DonSlaughter/garage-door/pcb/ext_libs/TSR_2-2450/TSR_2-2450.step

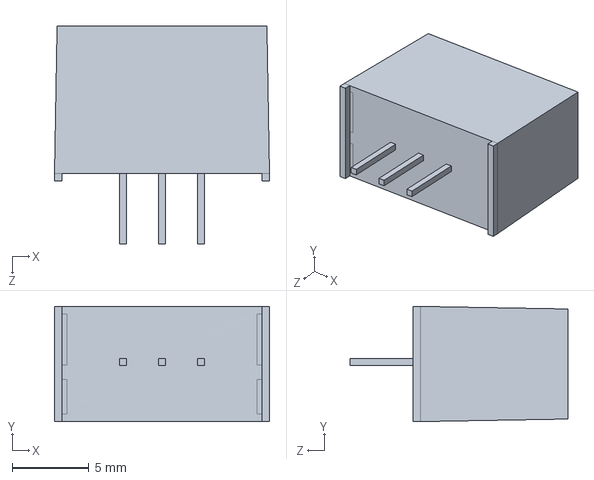
[picture p1: CAD file, 2022-01-19]
pcb/ext_libs/TSR_2-2450/TSR_2-2450.step
14.0 x 7.50 x 14.2 mm
