DonSlaughter/garage-door/pcb/garagen_pcb.kicad_pcb

## KiCad design pcb/garagen_pcb.kicad_pcb (2022-01-19)

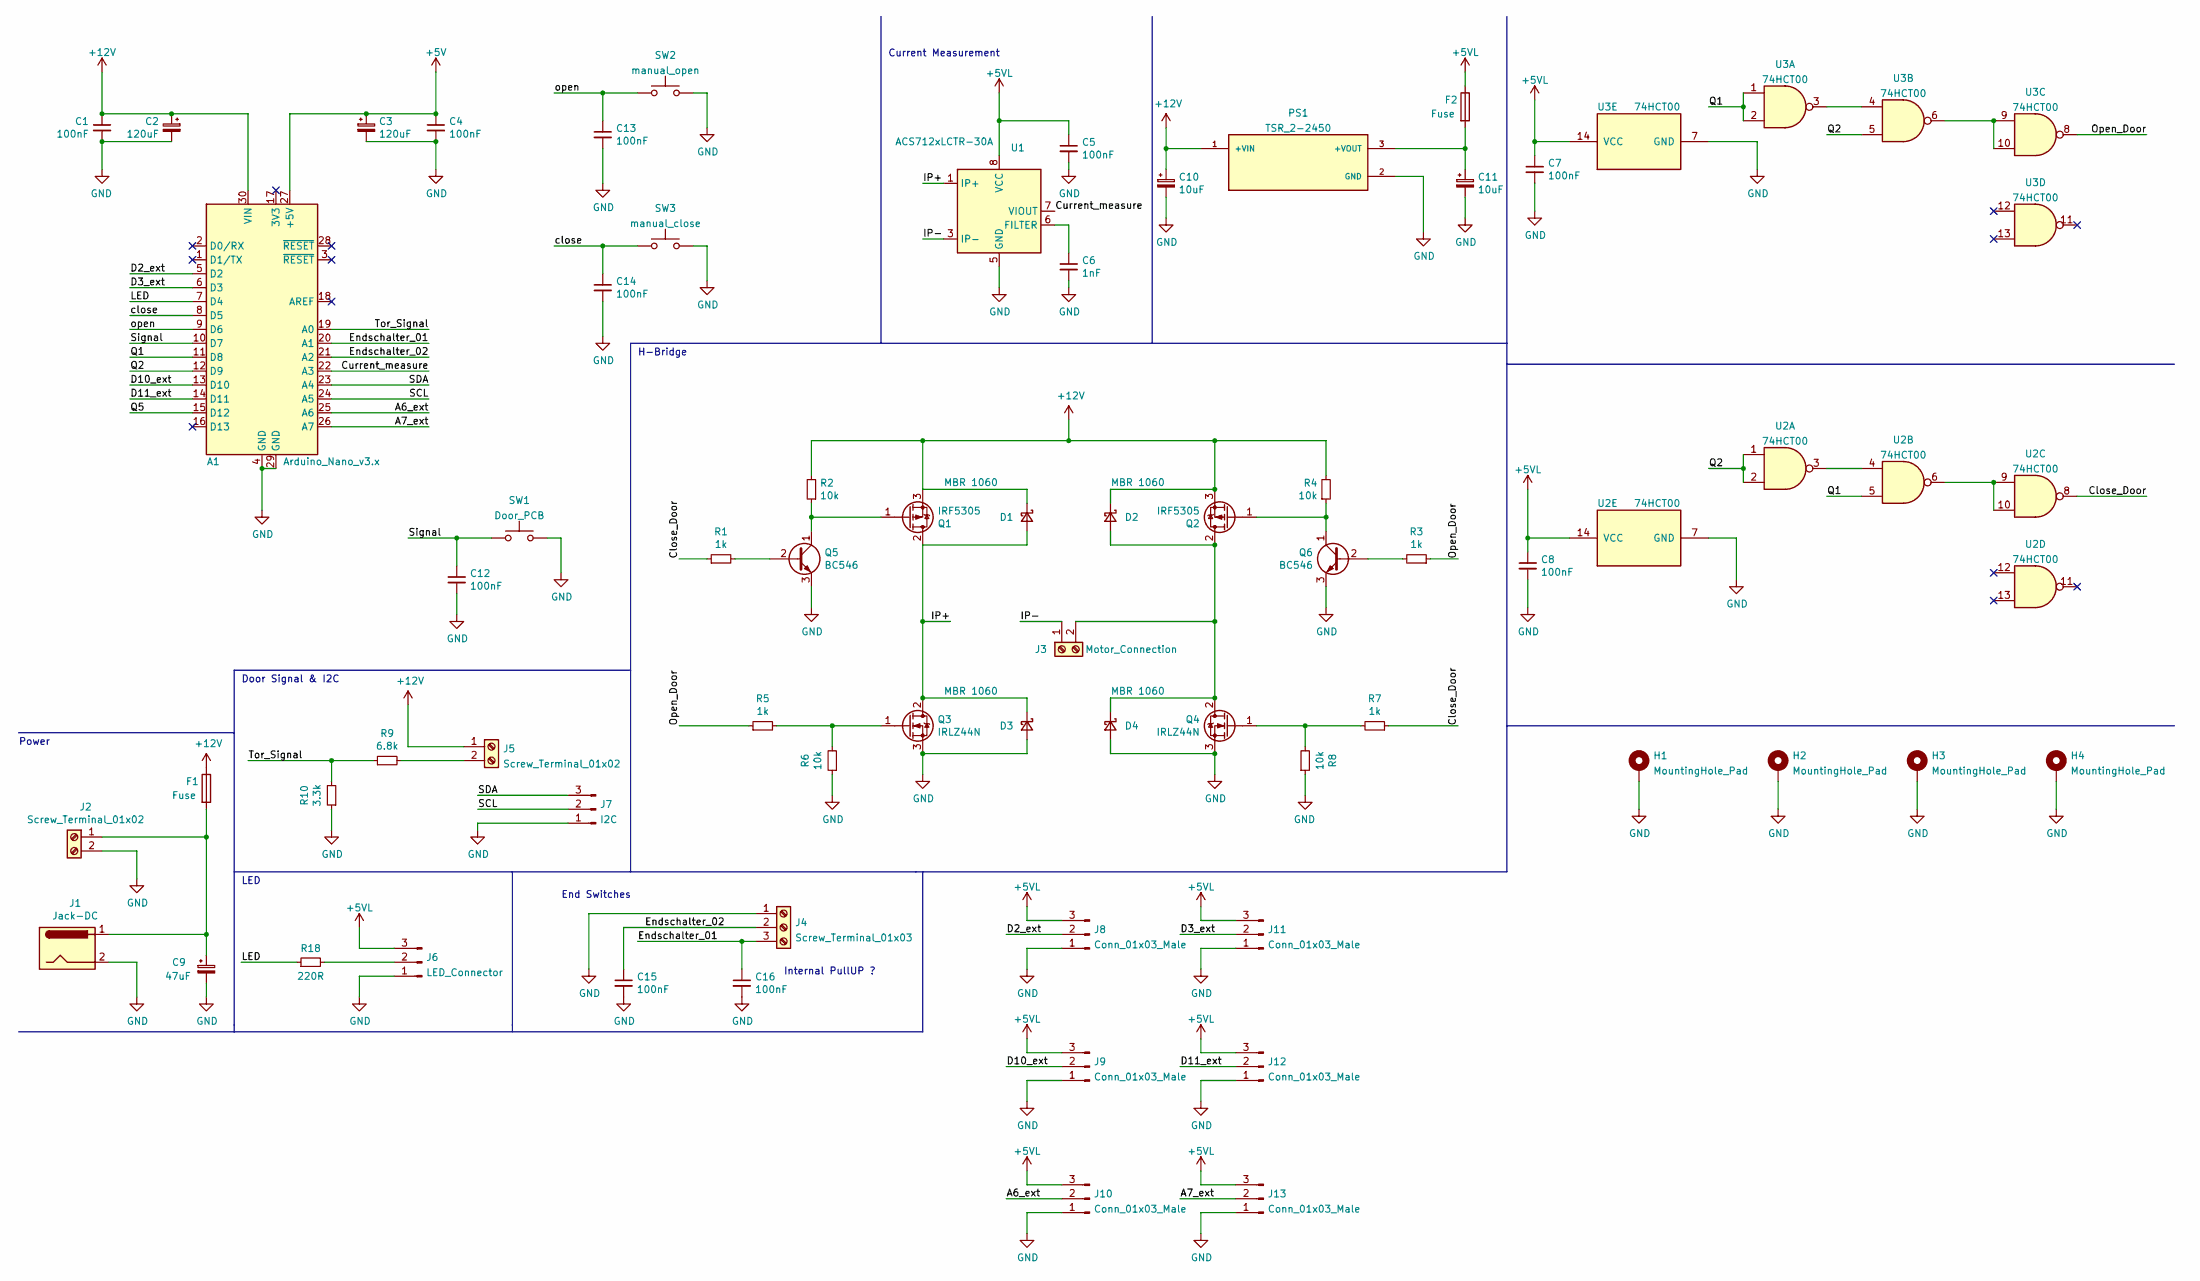
[picture p2: schematic garagen_pcb.kicad_sch]

Parts:
A1: Arduino_Nano_v3.x; Arduino_Nano
C1, C4, C5, C7, C8, C12, C13, C14, C15, C16: 100nF; C_Disc_D3.8mm_W2.6mm_P2.50mm
C2, C3: 120uF; CP_Radial_D6.3mm_P2.50mm
C6: 1nF; C_Disc_D3.8mm_W2.6mm_P2.50mm
C9: 47uF; CP_Radial_D6.3mm_P2.50mm
C10, C11: 10uF; CP_Radial_D6.3mm_P2.50mm
D1, D2, D3, D4: MBR 1060; TO-220-2_Vertical
F1, F2: Fuse; Fuseholder_Cylinder-5x20mm_Schurter_0031_8201_Horizontal_Op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
H1, H2, H3, H4: MountingHole_Pad; MountingHole_3.7mm_Pad_Via
J1: Jack-DC; BarrelJack_Horizontal
J2, J5: Screw_Terminal_01x02; TerminalBlock_Phoenix_PT-1,5-2-5.0-H_1x02_P5.00mm_Horizontal
J3: Motor_Connection; TerminalBlock_Phoenix_PT-1,5-2-5.0-H_1x02_P5.00mm_Horizontal
J4: Screw_Terminal_01x03; TerminalBlock_Phoenix_PT-1,5-3-5.0-H_1x03_P5.00mm_Horizontal
J6: LED_Connector; JST_XA_B03B-XASK-1_1x03_P2.50mm_Vertical
J7: I2C; JST_XA_B03B-XASK-1_1x03_P2.50mm_Vertical
J8, J9, J10, J11, J12, J13: Conn_01x03_Male; PinHeader_1x03_P2.54mm_Vertical
PS1: TSR_2-2450; CONV_TSR_2-2450; PARTREV May 14, 2020
Q1, Q2: IRF5305; TO-220-3_Vertical
Q3, Q4: IRLZ44N; TO-220-3_Vertical
Q5, Q6: BC546; TO-92_Inline
R1, R3, R5, R7: 1k; R_Axial_DIN0207_L6.3mm_D2.5mm_P10.16mm_Horizontal
R2, R4, R6, R8: 10k; R_Axial_DIN0207_L6.3mm_D2.5mm_P10.16mm_Horizontal
R9: 6.8k; R_Axial_DIN0207_L6.3mm_D2.5mm_P10.16mm_Horizontal
R10: 3.3k; R_Axial_DIN0207_L6.3mm_D2.5mm_P10.16mm_Horizontal
R18: 220R; R_Axial_DIN0207_L6.3mm_D2.5mm_P10.16mm_Horizontal
SW1: Door_PCB; SW_PUSH_6mm_H4.3mm
SW2: manual_open; SW_PUSH_6mm_H4.3mm
SW3: manual_close; SW_PUSH_6mm_H4.3mm
U1: ACS712xLCTR-30A; SOIC-8_3.9x4.9mm_P1.27mm
U2, U3: 74HCT00; DIP-14_W7.62mm_Socket

Connections:
+5V: A1.27 (+5V), C3.1, C4.1
+5VL: C5.1, C7.1, C8.1, F2.1, J6.3, J8.3, J9.3, J10.3, J11.3, J12.3, J13.3, U1.8 (VCC), U2.14 (VCC), U3.14 (VCC)
+12V: A1.30 (VIN), C1.1, C2.1, C10.1, D1.1 (K), D2.1 (K), F1.1, J5.1, PS1.1 (+VIN), Q1.3 (S), Q2.3 (S), R2.2, R4.2
/A6_ext: A1.25 (A6), J10.2
/A7_ext: A1.26 (A7), J13.2
/Close_Door: R1.1, R7.1, U2.8
/Current_measure: A1.22 (A3), U1.7 (VIOUT)
/D2_ext: A1.5 (D2), J8.2
/D3_ext: A1.6 (D3), J11.2
/D10_ext: A1.13 (D10), J9.2
/D11_ext: A1.14 (D11), J12.2
/Endschalter_01: A1.20 (A1), C16.1, J4.3
/Endschalter_02: A1.21 (A2), C15.1, J4.2
/IP+: D1.2 (A), D3.1 (K), Q1.2 (D), Q3.2 (D), U1.1 (IP+), U1.2 (IP+)
/IP-: J3.1, U1.3 (IP-), U1.4 (IP-)
/LED: A1.7 (D4), R18.1
/Open_Door: R3.1, R5.1, U3.8
/Q1: A1.11 (D8), U2.5, U3.1, U3.2
/Q2: A1.12 (D9), U2.1, U2.2, U3.5
/Q5: A1.15 (D12)
/SCL: A1.24 (A5), J7.2
/SDA: A1.23 (A4), J7.3
/Signal: A1.10 (D7), C12.1, SW1.1
/Tor_Signal: A1.19 (A0), R9.1, R10.2
/close: A1.8 (D5), C14.1, SW3.1
/open: A1.9 (D6), C13.1, SW2.1
GND: A1.4 (GND), A1.29 (GND), C1.2, C2.2, C3.2, C4.2, C5.2, C6.2, C7.2, C8.2, C9.2, C10.2, C11.2, C12.2, C13.2, C14.2, C15.2, C16.2, D3.2 (A), D4.2 (A), H1.1, H2.1, H3.1, H4.1, J1.2, J2.2, J4.1, J6.1, J7.1, J8.1, J9.1, J10.1, J11.1, J12.1, J13.1, PS1.2 (GND), Q3.3 (S), Q4.3 (S), Q5.3 (E), Q6.3 (E), R6.1, R8.1, R10.1, SW1.2, SW2.2, SW3.2, U1.5 (GND), U2.7 (GND), U3.7 (GND)
unnamed: C6.1, U1.6 (FILTER)
unnamed: C9.1, F1.2, J1.1, J2.1
unnamed: C11.1, F2.2, PS1.3 (+VOUT)
unnamed: D2.2 (A), D4.1 (K), J3.2, Q2.2 (D), Q4.2 (D)
unnamed: J5.2, R9.2
unnamed: J6.2, R18.2
unnamed: Q1.1 (G), Q5.1 (C), R2.1
unnamed: Q2.1 (G), Q6.1 (C), R4.1
unnamed: Q3.1 (G), R5.2, R6.2
unnamed: Q4.1 (G), R7.2, R8.2
unnamed: Q5.2 (B), R1.2
unnamed: Q6.2 (B), R3.2
unnamed: U2.3, U2.4
unnamed: U2.6, U2.9, U2.10
unnamed: U3.3, U3.4
unnamed: U3.6, U3.9, U3.10

Notes on the sheet:
Current Measurement
Power
Door Signal & I2C
Internal PullUP ?
End Switches
H-Bridge
LED

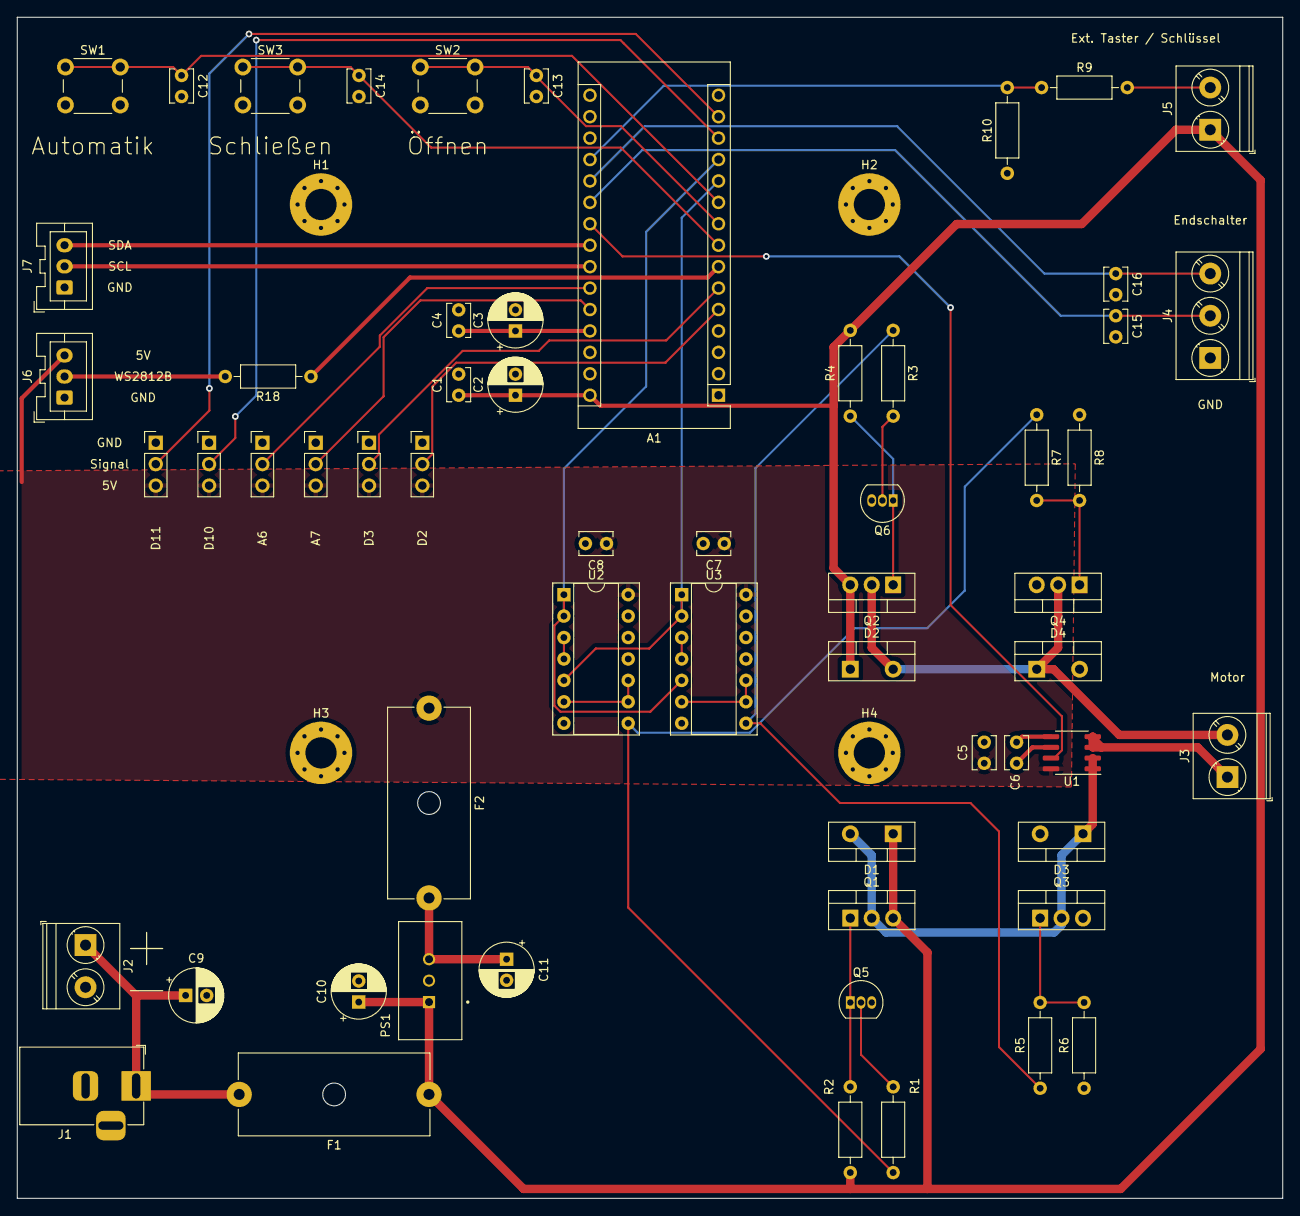
[picture p3: board garagen_pcb.kicad_pcb from above]

Board: 2 copper layers, 150.0 x 140.0 mm, 64 parts (0 on the bottom side), 42 nets.
