DonSlaughter/garage-door/(commit log)

2022-02-11 breadboard test
    [garagen_pcb.kicad_sch]
2022-03-11 don't allow illegal motor state in any case
    given the case:
    motor_start_down()
    ...
    motor_start_up()
    will set both pins high for a 'little' while.
2022-03-13 emergency buttons realised as button class
2022-03-13 button class with debounce delay constructor
2022-03-13 manual buttons working correctly
    [main.cpp]
2022-03-14 leds test
2022-03-15 led status
2022-03-16 not working timeoff -.-
    [main.cpp, main.h]
2022-03-16 .cache deleted and timer changes
